H-TejadaDeras/stm32g441kb/README.md

# stm32g441kb
STM32G441KB KiCAD Symbol, Footprint, and Development Board for Olin Electric Motorsports
