H-TejadaDeras/stm32g441kb/stm32g441kb data/stm32g441kb pinout.ods

Sheet: info
Key:
Red – Reserved
Orange – Selection 1, Reserved (External Crystal Oscillator, Firmware Flashing Pins, CAN)
Green – Selection 2 (SPI, 2 UART, ADC) (can have multiple uses)
Blue – Selection 3 (GPIO) (can have multiple uses)
Bolded – Available Selected Function
Everything except for TIM6 and TIM7 can do PWM (sec. 3.25)

Sheet: stm32g441kb pinout
Position | Max Voltage (sec. 4.10) | Name | Type | Signal | Label | ADC Connections | GPIO Functions | AF0 | AF1 | AF2 | AF3 | AF4 | AF5 | AF6 | AF7 | AF8 | AF9 | AF10 | AF11 | AF12 | AF13 | AF14 | AF15
1 |  | VDD | Power
2 | 5V | PF0-OSC_IN | I/O |  |  |  |  |  |  |  |  | I2C2_SDA | I2S2_WS/SPI2_NSS | TIM1_CH3N |  |  |  |  |  |  |  |  | EVENTOUT
3 | 5V | PF1-OSC_OUT | I/O |  |  |  |  |  |  |  |  |  | I2S2_CK/SPI2_SCK |  |  |  |  |  |  |  |  |  | EVENTOUT
4 | 5V | PG10-NRST | I/O |  |  |  | GPIO, GPIO_EXTI10 | RCC_MCO |  |  |  |  |  |  |  |  |  |  |  |  |  |  | EVENTOUT
5 | 3.6V | PA0 | I/O |  |  | ADC1_IN1, ADC2_IN1 | GPIO, GPIO_EXTI0 |  | TIM2_CH1 |  |  |  |  |  | USART2_CTS/USART2_NSS | COMP1_OUT | TIM8_BKIN | TIM8_ETR |  |  |  | TIM2_ETR | EVENTOUT
6 | 3.6V | PA1 | I/O |  |  | ADC1_IN2, ADC2_IN2 | GPIO, GPIO_EXTI1 | RTC_REFIN | TIM2_CH2 |  |  |  |  |  | USART2_DE/USART2_RTS |  | TIM15_CH1N |  |  |  |  |  | EVENTOUT
7 | 3.6V | PA2 | I/O |  |  | ADC1_IN3 | GPIO, GPIO_EXTI2 |  | TIM2_CH3 |  |  |  |  |  | USART2_TX | COMP2_OUT | TIM15_CH1 |  |  | LPUART1_TX |  | UCPD1_FRSTX1/UCPD1_FRSTX2 | EVENTOUT
8 | 3.6V | PA3 | I/O |  |  | ADC1_IN4 | GPIO, GPIO_EXTI3 |  | TIM2_CH4 |  | SAI1_CK1 |  |  |  | USART2_RX |  | TIM15_CH2 |  |  | LPUART1_RX | SAI1_MCLK_A |  | EVENTOUT
9 | 3.6V | PA4 | I/O |  |  | ADC2_IN17 | GPIO, GPIO_EXTI4 |  |  | TIM3_CH2 |  |  | SPI1_NSS | I2S3_WS/SPI3_NSS | USART2_CK |  |  |  |  |  | SAI1_FS_B |  | EVENTOUT
10 | 3.6V | PA5 | I/O |  |  | ADC2_IN13 | GPIO, GPIO_EXTI5 |  | TIM2_CH1 | TIM2_ETR |  |  | SPI1_SCK |  |  |  |  |  |  |  |  | UCPD1_FRSTX1/UCPD1_FRSTX2 | EVENTOUT
11 | 3.6V | PA6 | I/O |  |  | ADC2_IN3 | GPIO, GPIO_EXTI6 |  | TIM16_CH1 | TIM3_CH1 |  | TIM8_BKIN | SPI1_MISO | TIM1_BKIN |  | COMP1_OUT |  |  |  | LPUART1_CTS |  |  | EVENTOUT
12 | 3.6V | PA7 | I/O |  |  | ADC2_IN4 | GPIO, GPIO_EXTI7 |  | TIM17_CH1 | TIM3_CH2 |  | TIM8_CH1N | SPI1_MOSI | TIM1_CH1N |  | COMP2_OUT |  |  |  |  |  | UCPD1_FRSTX1/UCPD1_FRSTX2 | EVENTOUT
13 | 3.6V | PB0 | I/O |  |  | ADC1_IN15 | GPIO, GPIO_EXTI0 |  |  | TIM3_CH3 |  | TIM8_CH2N |  | TIM1_CH2N |  |  |  |  |  |  |  | UCPD1_FRSTX1/UCPD1_FRSTX2 | EVENTOUT
14 |  | VSSA | Power
15 |  | VDDA | Power
16 |  | VSS | Power
17 |  | VDD | Power
18 | 5V | PA8 | I/O |  |  |  | GPIO, GPIO_EXTI8 | RCC_MCO |  | I2C3_SCL |  | I2C2_SDA | I2S2_MCK | TIM1_CH1 | USART1_CK |  |  | TIM4_ETR |  | SAI1_CK2 |  | SAI1_SCK_A | EVENTOUT
19 | 5V | PA9 | I/O |  |  |  | GPIO, GPIO_EXTI9 |  |  | I2C3_SMBA |  | I2C2_SCL | I2S3_MCK | TIM1_CH2 | USART1_TX |  | TIM15_BKIN | TIM2_CH3 |  |  |  | SAI1_FS_A | EVENTOUT
20 | 5V | PA10 | I/O |  |  |  | GPIO, GPIO_EXTI10 |  | TIM17_BKIN |  | CRS_SYNC | I2C2_SMBA | SPI2_MISO | TIM1_CH3 | USART1_RX |  |  | TIM2_CH4 | TIM8_BKIN | SAI1_D1 |  | SAI1_SD_A | EVENTOUT
21 | 5V | PA11 | I/O |  |  |  | GPIO, GPIO_EXTI11 |  |  |  |  |  | I2S2_SD/SPI2_MOSI | TIM1_CH1N | USART1_CTS/USART1_NSS | COMP1_OUT | FDCAN1_RX | TIM4_CH1 | TIM1_CH4 | TIM1_BKIN2 |  |  | EVENTOUT
22 | 5V | PA12 | I/O |  |  |  | GPIO, GPIO_EXTI12 |  | TIM16_CH1 |  |  |  | I2S_CKIN | TIM1_CH2N | USART1_DE/USART1_RTS | COMP2_OUT | FDCAN1_TX | TIM4_CH2 | TIM1_ETR |  |  |  | EVENTOUT
23 | 5V | PA13 | I/O |  |  |  | GPIO, GPIO_EXTI13 | SYS_JTMS-SWDIO | TIM16_CH1N |  |  | I2C1_SCL | IR_OUT |  |  |  |  | TIM4_CH3 |  |  | SAI1_SD_B |  | EVENTOUT
24 | 5V | PA14 | I/O |  |  |  | GPIO, GPIO_EXTI14 | SYS_JTCK-SWCLK | LPTIM1_OUT |  |  | I2C1_SDA | TIM8_CH2 | TIM1_BKIN | USART2_TX |  |  |  |  |  | SAI1_FS_B |  | EVENTOUT
25 | 5V | PA15 | I/O |  |  |  | GPIO, GPIO_EXTI15 | SYS_JTDI | TIM2_CH1 | TIM8_CH1 |  | I2C1_SCL | SPI1_NSS | I2S3_WS/SPI3_NSS | USART2_RX |  | TIM1_BKIN |  |  |  |  | TIM2_ETR | EVENTOUT
26 | 5V | PB3 | I/O |  |  |  | GPIO, GPIO_EXTI3 | SYS_JTDO-SWO | TIM2_CH2 | TIM4_ETR | CRS_SYNC | TIM8_CH1N | SPI1_SCK | I2S3_CK/SPI3_SCK | USART2_TX |  |  | TIM3_ETR |  |  |  | SAI1_SCK_B | EVENTOUT
27 | 5V | PB4 | I/O |  |  |  | GPIO, GPIO_EXTI4 | SYS_JTRST | TIM16_CH1 | TIM3_CH1 |  | TIM8_CH2N | SPI1_MISO | SPI3_MISO | USART2_RX |  |  | TIM17_BKIN |  |  |  | SAI1_MCLK_B | EVENTOUT
28 | 5V | PB5 | I/O |  |  |  | GPIO, GPIO_EXTI5 |  | TIM16_BKIN | TIM3_CH2 | TIM8_CH3N | I2C1_SMBA | SPI1_MOSI | I2S3_SD/SPI3_MOSI | USART2_CK | I2C3_SDA |  | TIM17_CH1 | LPTIM1_IN1 | SAI1_SD_B |  |  | EVENTOUT
29 | 5V | PB6 | I/O |  |  |  | GPIO, GPIO_EXTI6 |  | TIM16_CH1N | TIM4_CH1 |  |  | TIM8_CH1 | TIM8_ETR | USART1_TX | COMP4_OUT |  | TIM8_BKIN2 | LPTIM1_ETR |  |  | SAI1_FS_B | EVENTOUT
30 | 5V | PB7 | I/O |  |  |  | GPIO, GPIO_EXTI7 |  | TIM17_CH1N | TIM4_CH2 |  | I2C1_SDA | TIM8_BKIN |  | USART1_RX | COMP3_OUT |  | TIM3_CH4 | LPTIM1_IN2 |  |  |  | EVENTOUT
31 | 5V | PB8-BOOT0 | I/O |  |  |  | GPIO, GPIO_EXTI8 |  | TIM16_CH1 | TIM4_CH3 | SAI1_CK1 | I2C1_SCL |  |  |  | COMP1_OUT | FDCAN1_RX | TIM8_CH2 |  | TIM1_BKIN |  | SAI1_MCLK_A | EVENTOUT
32 |  | VSS | Power
