H-TejadaDeras/stm32g441kb/kicad files/3d models/MCP2561-E_SN.stp

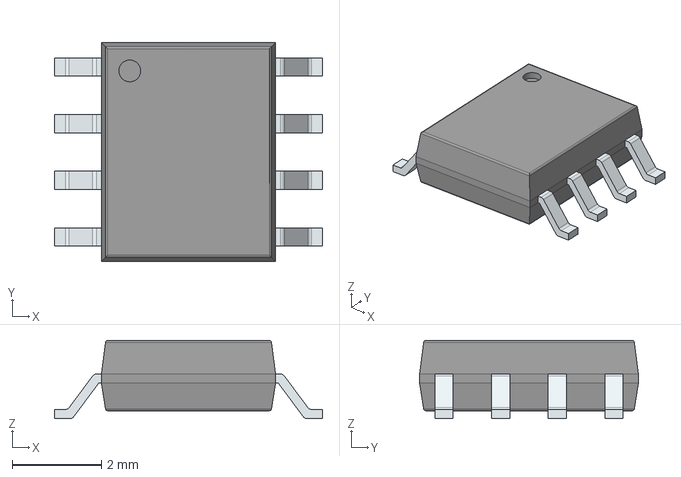
[picture p1: CAD file, 2025-08-19]
kicad files/3d models/MCP2561-E_SN.stp
6.00 x 4.90 x 1.75 mm
PinsArrayLR
