H-TejadaDeras/stm32g441kb/kicad files/3d models/LQFP-32.step

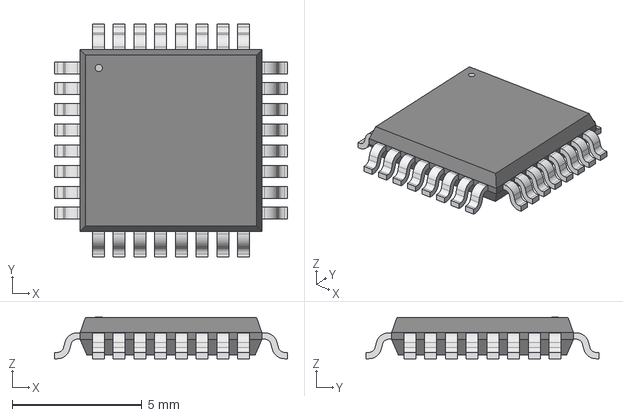
[picture p2: CAD file, 2025-08-19]
kicad files/3d models/LQFP-32.step
8.99 x 8.99 x 1.60 mm
