H-TejadaDeras/stm32g441kb/kicad files/3d models/IND_BOURNS_SRR5018.step

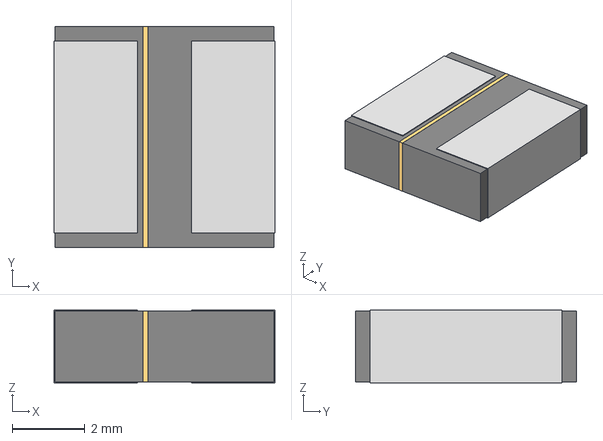
[picture p3: CAD file, 2025-08-19]
kicad files/3d models/IND_BOURNS_SRR5018.step
6.10 x 6.10 x 2.01 mm
