H-TejadaDeras/stm32g441kb/kicad files/3d models/AP63203WU-7_DIO.step

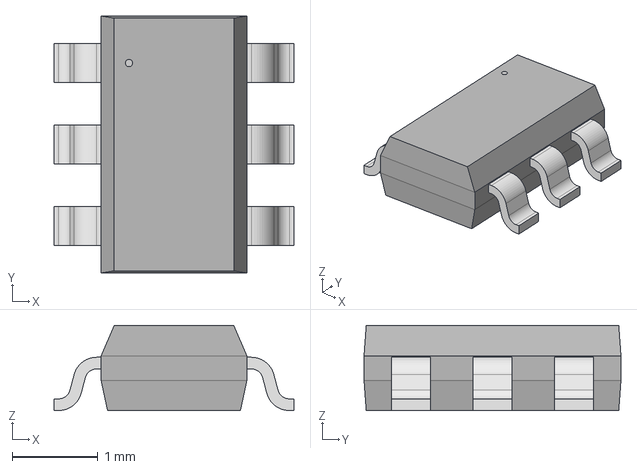
[picture p4: CAD file, 2025-08-19]
kicad files/3d models/AP63203WU-7_DIO.step
2.79 x 3.00 x 0.993 mm
