H-TejadaDeras/stm32g441kb/(commit log)

2025-07-24 Add Datasheet and Pinout for STM32G441KBT6; Started KiCAD Symbol
    [stm32g441kb pinout.ods]
2025-07-24 Added ADC and GPIO pinouts
    [stm32g441kb pinout.ods]
2025-07-26 Added Pin Definitions and Created Pin Categories
2025-07-26 Added Footprint; Small Symbol Adjustments
2025-07-27 Minor Visual Changes to Symbols, Removed Basic and Advanced Timers from Simplified Pinout
    [stm32g441kb pinout.ods]
2025-07-27 Fixed configuration issue with symbol attributes (symbol was omitted from BOM and things)
2025-07-31 Seperated Power -> 3.3 V and GND in symbols.
2025-08-14 Added Keyed Programming Pin Header, LDO Voltage Regulator, and reference manual
    [stm32g441kbt6 development.kicad_pcb, stm32g441kbt6 development.kicad_sch]
2025-08-14 Added Debug LEDs, Some Test Points, Minor changes to STM32G441KBT6 symbol
    [stm32g441kbt6 development.kicad_sch]
2025-08-16 Condensed Symbol Design; Slight changes to development board
    [stm32g441kbt6 development.kicad_sch]
2025-08-16 Added footprints for new voltage regulator components, added test points and other things
    [stm32g441kbt6 development.kicad_pcb, stm32g441kbt6 development.kicad_sch]
2025-08-19 Added 3D Models, Started PCB Design, Minor Fixes to Schematics
    [AP63203WU-7_DIO.step, IND_BOURNS_SRR5018.step, LQFP-32.step, MCP2561-E_SN.stp, stm32g441kbt6 development.kicad_pcb, stm32g441kbt6 development.kicad_sch]
2025-08-19 Finished PCB Design
    [stm32g441kbt6 development.kicad_pcb]
2025-08-20 Added Datasheet References, Minor PCB Design Changes
    [stm32g441kbt6 development.kicad_pcb, stm32g441kbt6 development.kicad_sch]
2025-08-20 Added Minor PCB Cosmetic and Schematic Things
    [stm32g441kbt6 development.kicad_pcb, stm32g441kbt6 development.kicad_sch]
2025-08-20 Added Fab Files for PCB
    [stm32g441kbt6 development.kicad_pcb]
2025-08-20 Added Fab Files for PCB with Rounded Corners
    [stm32g441kbt6 development vrounded corners.kicad_pcb]
2025-08-21 Changed Crystal Oscillator Load Capacitors to 30 pF from 18 pF (this should provide the manufacturer's specified load capacitance)
    [stm32g441kbt6 development vrounded corners.kicad_pcb, stm32g441kbt6 development.kicad_pcb, stm32g441kbt6 development.kicad_sch]
